daiilvvyeyo/WRO-2026-Future-Engineers-Superiores/vehicle photos/README.md

# Vehicle Photos

Photographic documentation of the vehicle's development.

This folder contains images showing different versions, construction stages, modifications, components, and testing of the vehicle.
