daiilvvyeyo/WRO-2026-Future-Engineers-Superiores/schemes/README.md

# Schemes

Technical diagrams and system schematics of the vehicle.

This folder contains diagrams related to connections, components, electronics, sensors, and other technical systems.
