daiilvvyeyo/WRO-2026-Future-Engineers-Superiores/prototype/README.md

# Prototype

Documentation of the vehicle's prototype development.

This folder contains early designs, experiments, modifications, and different prototype stages developed throughout the project.
