daiilvvyeyo/WRO-2026-Future-Engineers-Superiores/evidences/README.md

# Evidences

Documentation and evidence of the vehicle's development and testing process.

This folder contains tests, experiments, results, and other materials that demonstrate the progress of the project.
