daiilvvyeyo/WRO-2026-Future-Engineers-Superiores/codes/README.md

# Codes

Source code developed for the WRO Future Engineers 2026 vehicle.

This folder contains the programs used for autonomous driving, sensor control, movement, navigation, and decision-making during the challenges.
