daiilvvyeyo/WRO-2026-Future-Engineers-Superiores/others/README .md

# Others

Additional materials related to the development of the project.

This folder contains supporting files and resources that do not belong to the other project categories.
