daiilvvyeyo/WRO-2026-Future-Engineers-Superiores/others/Axis module.png

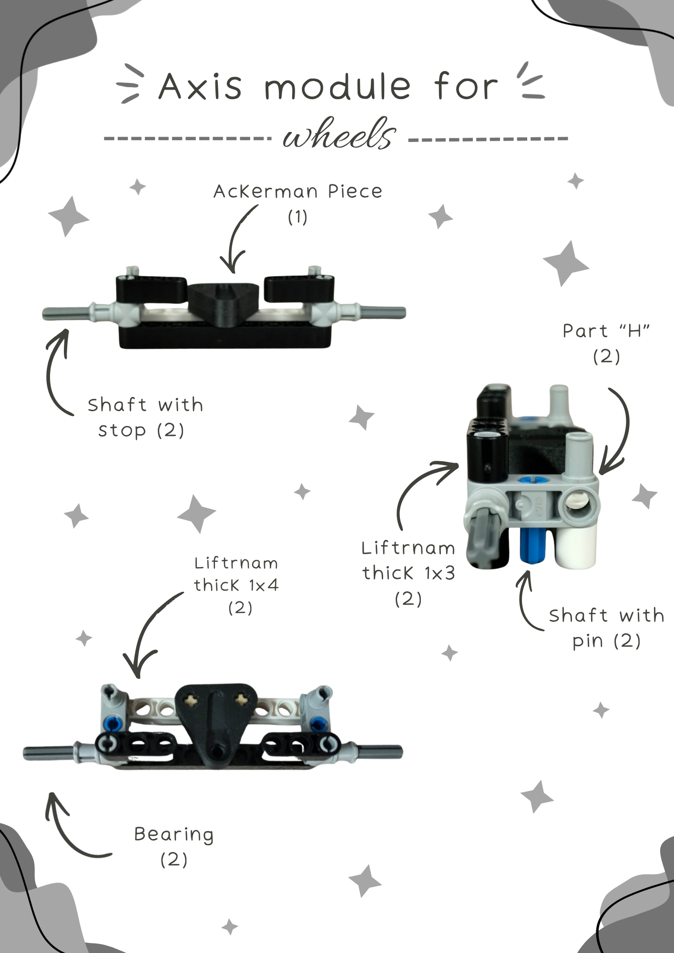
others/Axis module.png
