daiilvvyeyo/WRO-2026-Future-Engineers-Superiores/others/Car differential.png

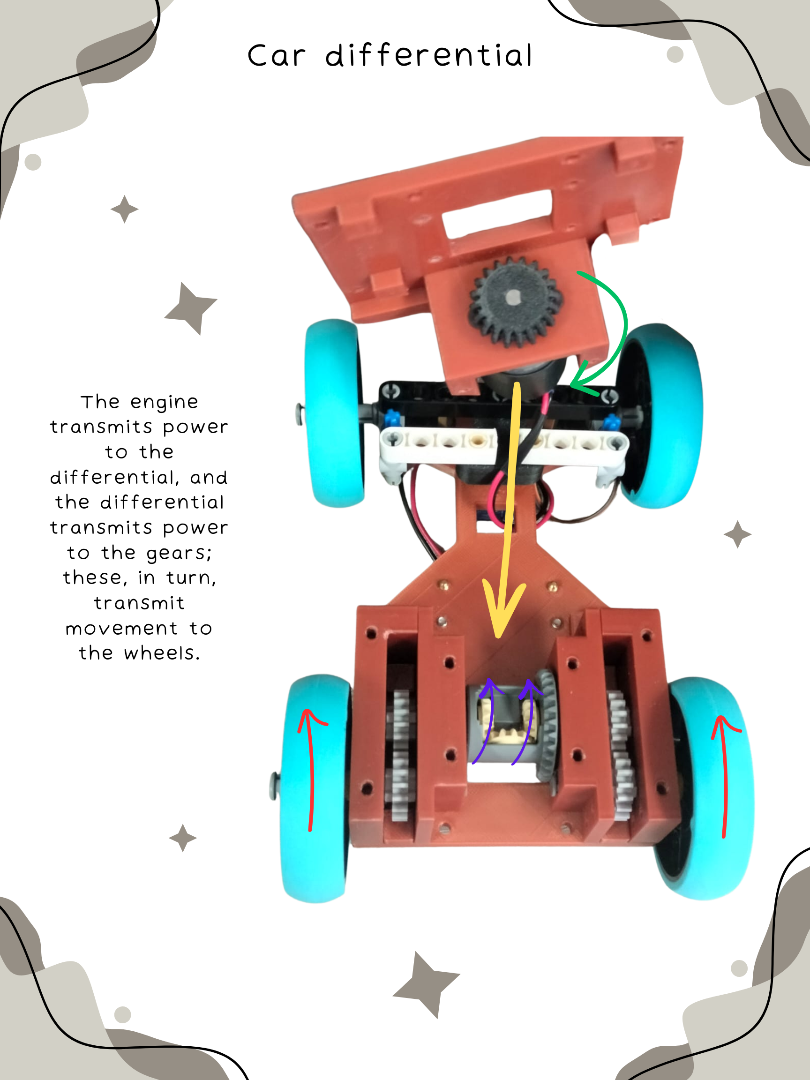
others/Car differential.png
