daiilvvyeyo/WRO-2026-Future-Engineers-Superiores/prototype/Back.jpeg

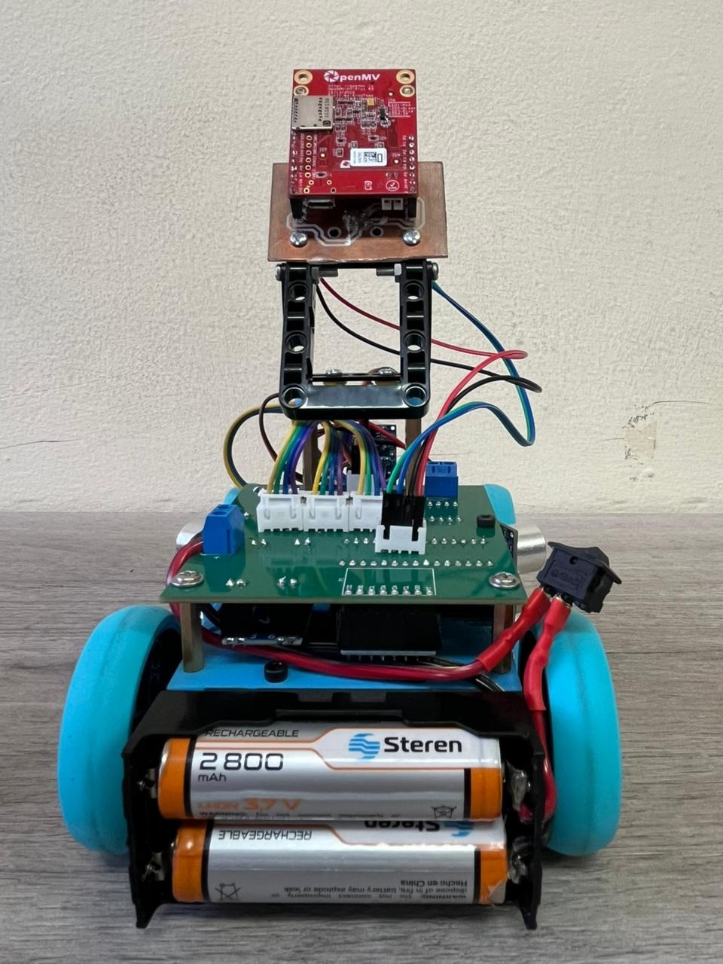
prototype/Back.jpeg
