daiilvvyeyo/WRO-2026-Future-Engineers-Superiores/prototype/Bottom.jpeg

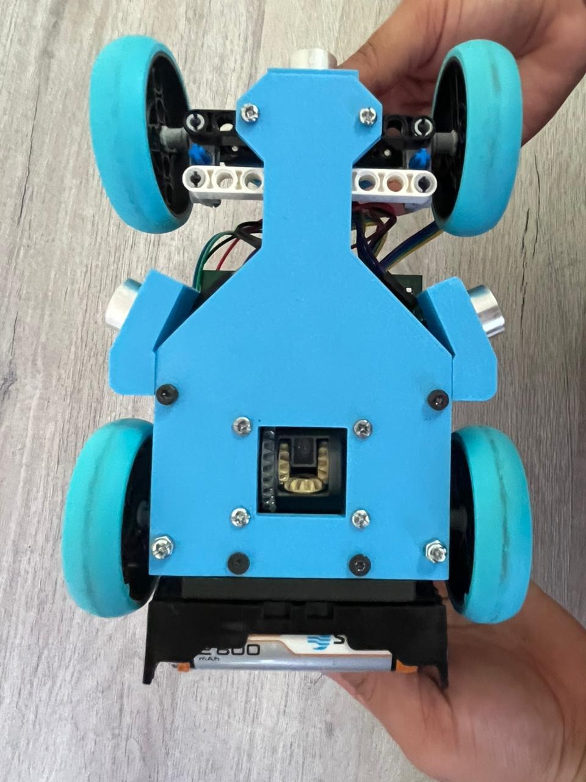
prototype/Bottom.jpeg
