daiilvvyeyo/WRO-2026-Future-Engineers-Superiores/prototype/Front.jpeg

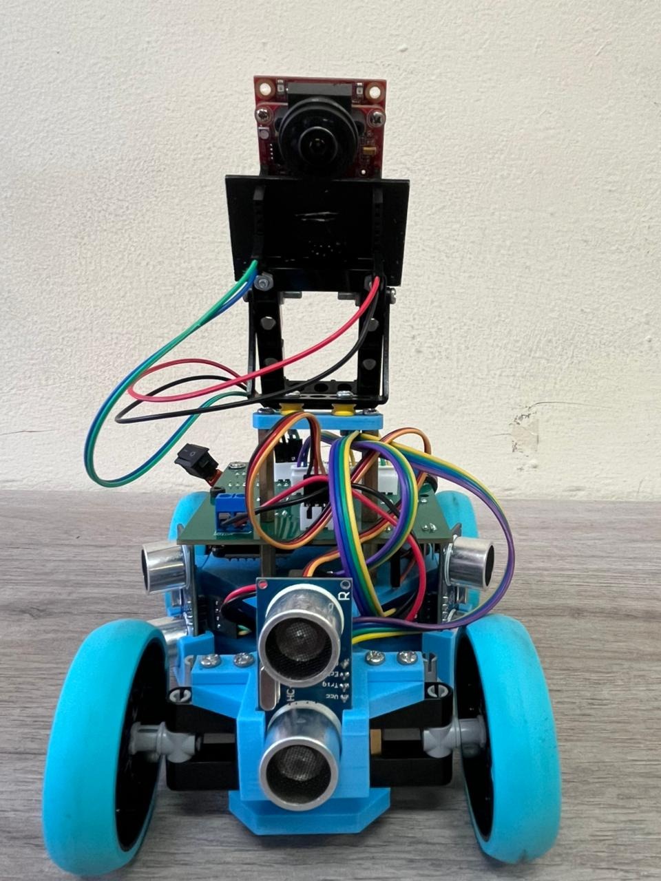
prototype/Front.jpeg
