daiilvvyeyo/WRO-2026-Future-Engineers-Superiores/prototype/Left.jpeg

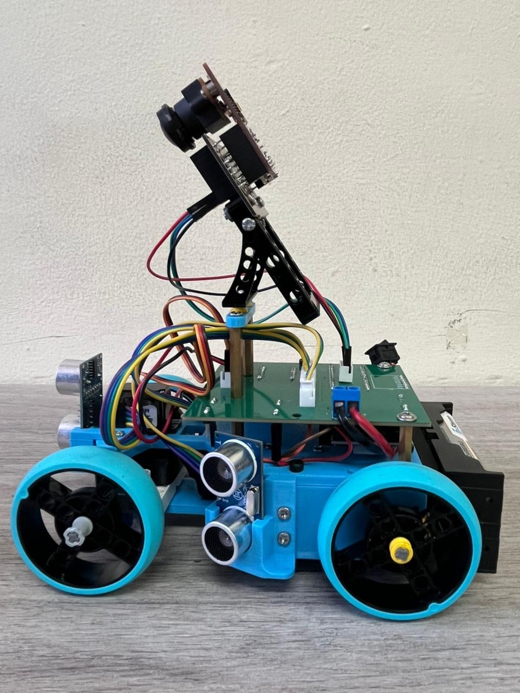
prototype/Left.jpeg
