daiilvvyeyo/WRO-2026-Future-Engineers-Superiores/prototype/Right.jpeg

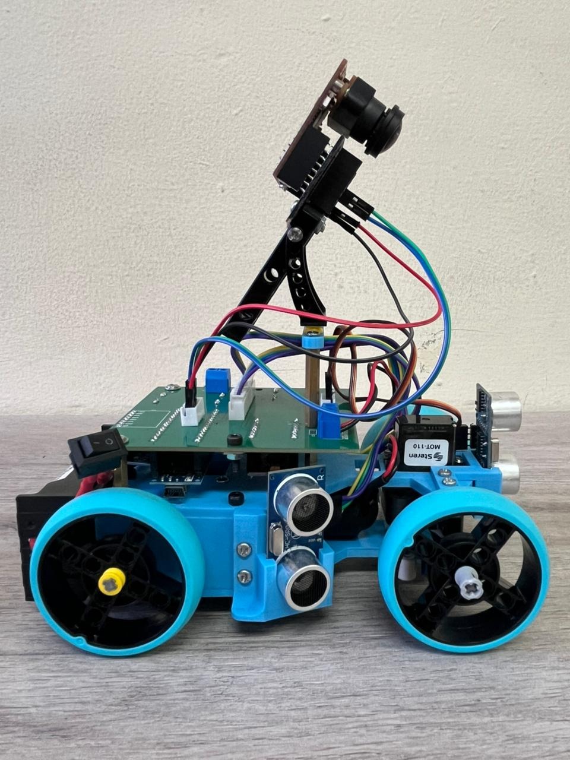
prototype/Right.jpeg
