daiilvvyeyo/WRO-2026-Future-Engineers-Superiores/prototype/Top.jpeg

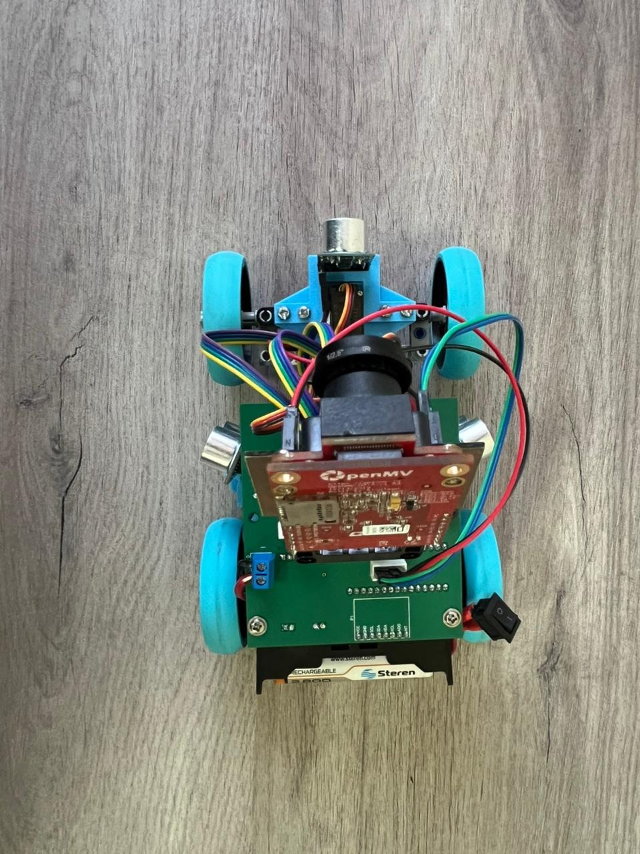
prototype/Top.jpeg
