daiilvvyeyo/WRO-2026-Future-Engineers-Superiores/schemes/PCB_Real.jpeg

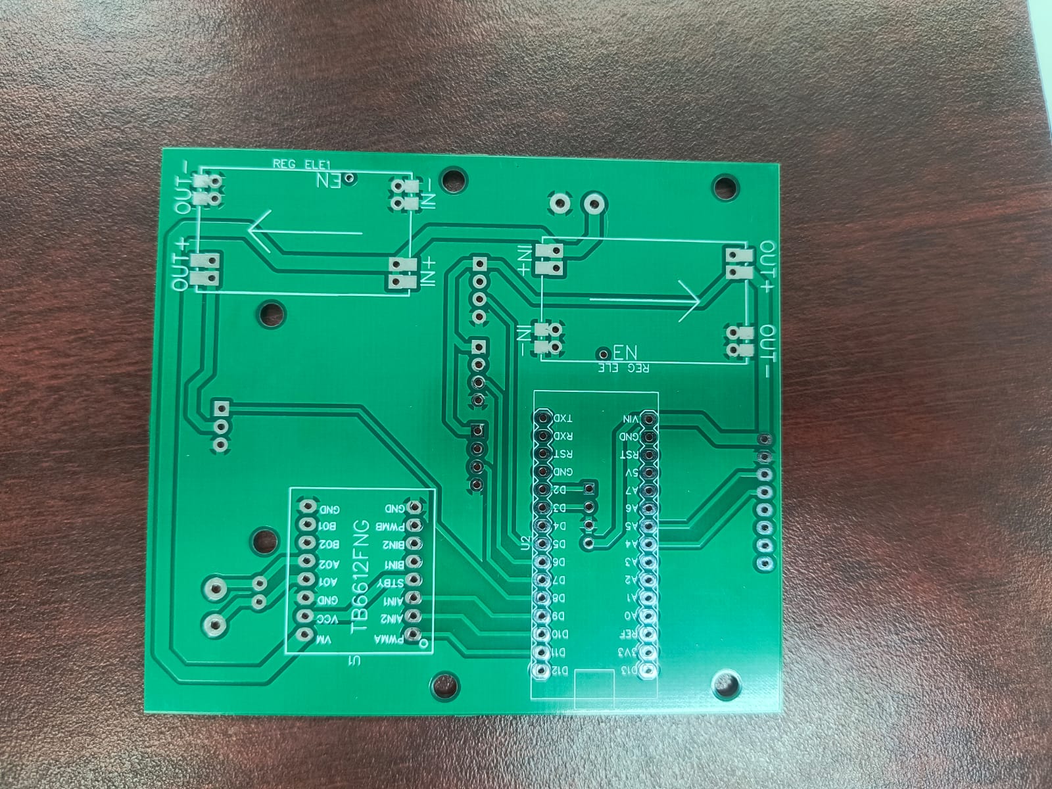
schemes/PCB_Real.jpeg
