daiilvvyeyo/WRO-2026-Future-Engineers-Superiores/team photos/funnyphoto.jpg

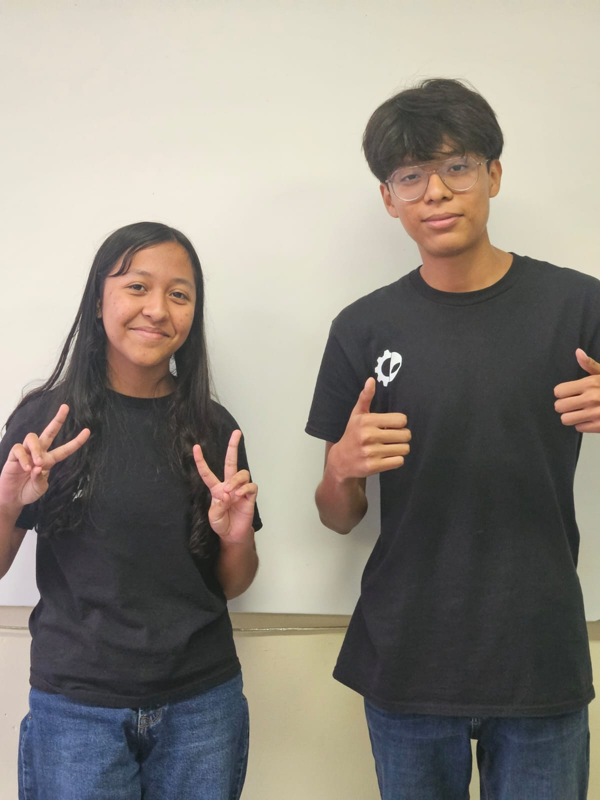
team photos/funnyphoto.jpg
