daiilvvyeyo/WRO-2026-Future-Engineers-Superiores/logbook/README.md

# Logbook

Chronological record of the development of the WRO Future Engineers 2026 project.

It includes important decisions, tests, problems, solutions, modifications, and project milestones.
