daiilvvyeyo/WRO-2026-Future-Engineers-Superiores/(commit log)

2026-05-23 Expand README with project details and technical insights
    Added detailed project overview, chassis design, steering system, traction system, power architecture, sensor selection, software architecture, and testing results for the WRO 2026 robot.
2026-06-13 Update PCB & Wiring Implementation section header
2026-06-13 Modify heading for Chassis Design & Iteration section
    Updated the section heading for Chassis Design & Iteration.
2026-08-09 Revise steering system details and add vehicle photos
    Updated the steering system section to reflect changes in servo selection and design improvements. Added vehicle photos and clarified the steering geometry details.
2026-08-22 Add section on power and reverse polarity incident
    Documented a reverse polarity incident during testing and its resolution.
2026-08-22 Enhance README with ultrasonic sensor and PCB details
    Expanded the ultrasonic sensor section to include details on the upgrade from 3 to 5 sensors for improved distance measurement. Added information about PCB issues related to solder bridges and reverse polarity incidents.
2026-08-22 Enhance README with vision module and parking strategy
    Added section on WS2812B RGB LED matrix module integration for improved vision processing. Updated parking strategy details.
2026-09-12 Add track challenges to README
    Added challenges for track navigation and obstacle avoidance.
2026-09-16 Enhance repository structure documentation with flowchart
    Updated repository structure section to include a flowchart representation.
2026-09-16 Enhance README with Arduino and ESP32 details
    Added detailed descriptions of Arduino Nano and ESP32 functionalities, including main functions and links to their respective code files.
2026-09-16 Add README.md for additional project materials
2026-09-16 Add README.md for prototype documentation
2026-09-16 Refactor README structure and enhance PCB section
    Updated section headers and improved formatting for PCB and wiring implementation.
